mi3nts/PCBMints2025/README.md

# PCBMints2025
Contains PCB designs for MINTS Projects
