mi3nts/PCBMints2025/eagle/methaneSensing/inir2me5/back.png

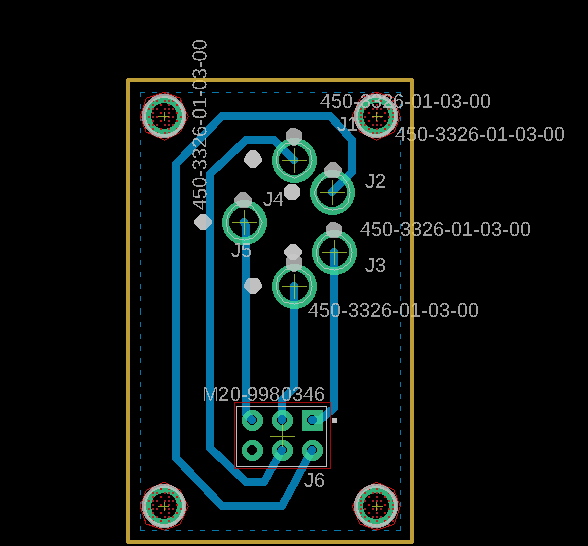
eagle/methaneSensing/inir2me5/back.png
