mi3nts/PCBMints2025/eagle/methaneSensing/sjh5a/back.png

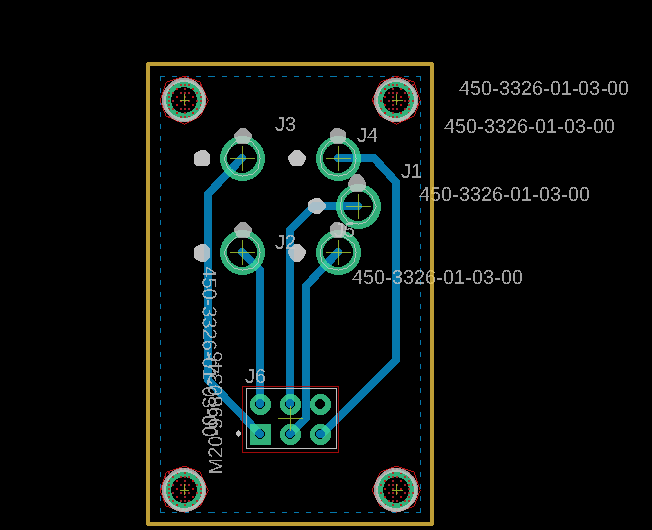
eagle/methaneSensing/sjh5a/back.png
