mi3nts/PCBMints2025/eagle/methaneSensing/tgs2611c00V2/back.png

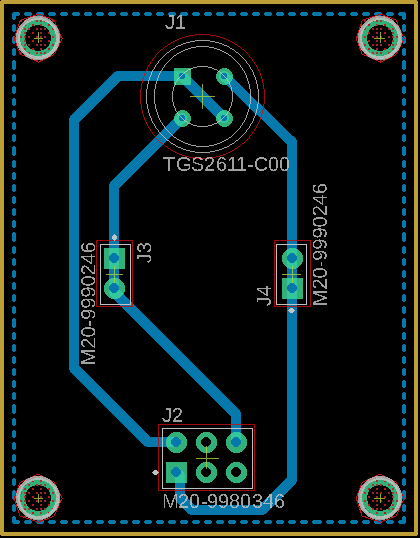
eagle/methaneSensing/tgs2611c00V2/back.png
