mi3nts/PCBMints2025/kiCad/hat/assets/MMUN2133LT1G.step

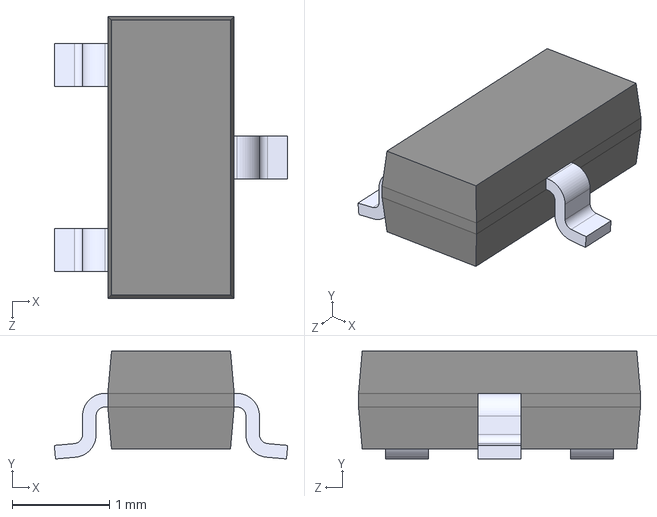
[picture p4: CAD file, 2025-10-30]
kiCad/hat/assets/MMUN2133LT1G.step
2.40 x 1.11 x 2.90 mm
