mi3nts/PCBMints2025/kiCad/hat/assets/RC0603FR-0717K4L.step

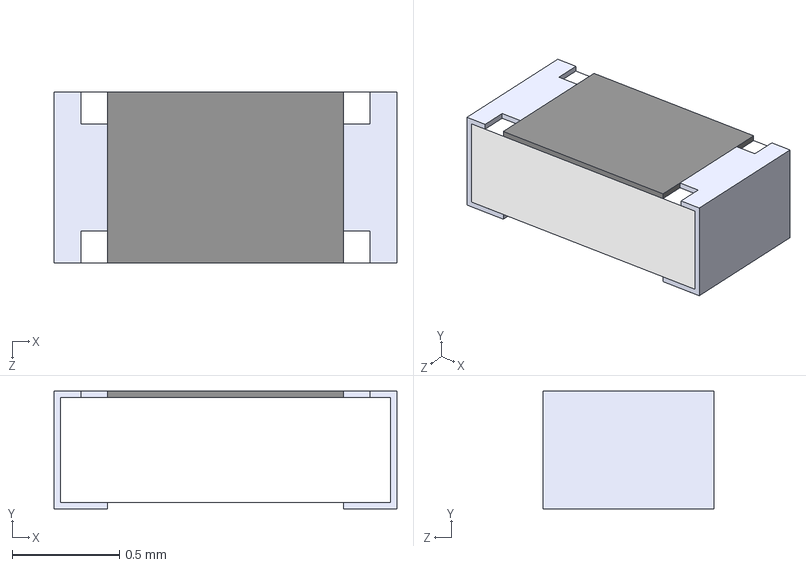
[picture p5: CAD file, 2025-10-30]
kiCad/hat/assets/RC0603FR-0717K4L.step
1.60 x 0.55 x 0.8 mm
