mi3nts/PCBMints2025/res/TGS2611-C00.stp

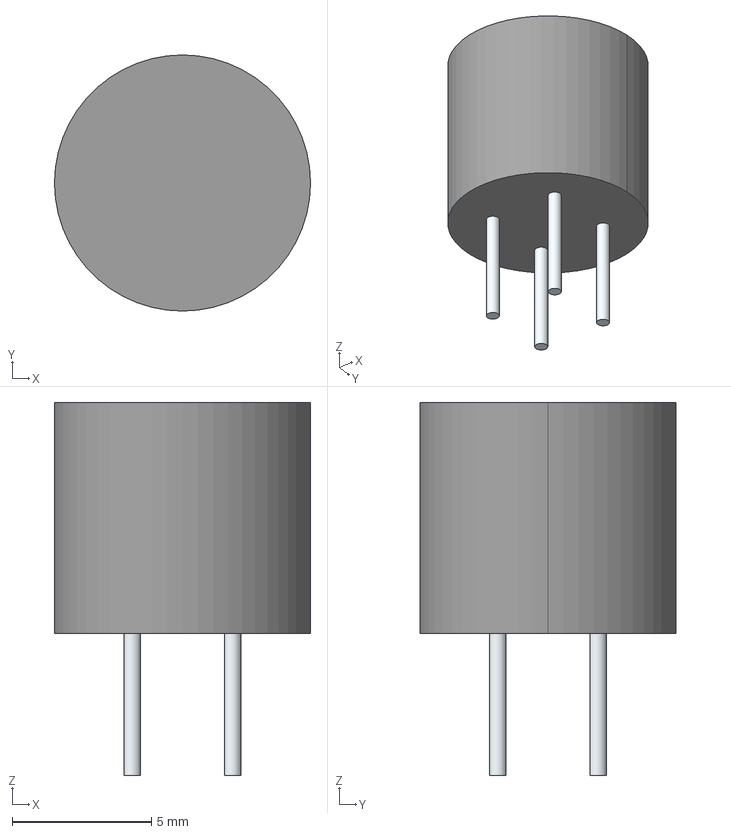
[picture p6: CAD file, 2026-06-27]
res/TGS2611-C00.stp
9.20 x 9.20 x 13.4 mm
Leads x 4
