mi3nts/PCBMints2025/res/5013310607.stp

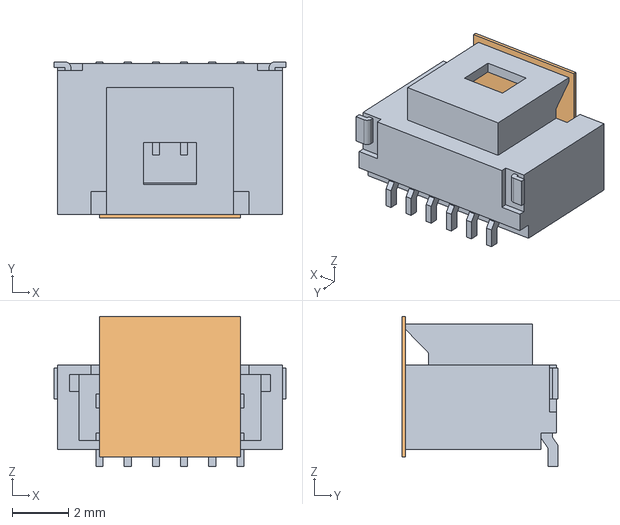
[picture p7: CAD file, 2026-06-27]
res/5013310607.stp
8.24 x 5.54 x 5.34 mm
