mi3nts/PCBMints2025/res/m20-7830542.stp

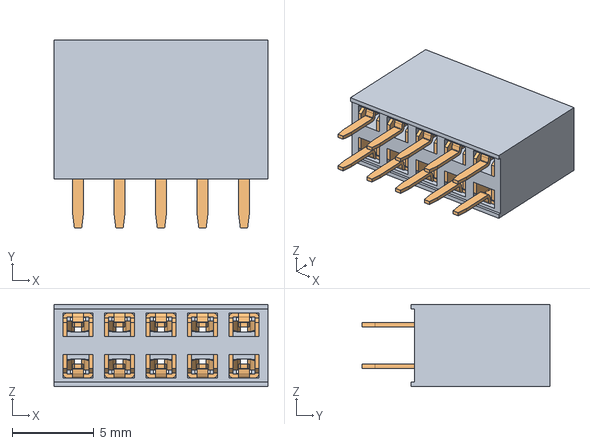
[picture p8: CAD file, 2026-06-27]
res/m20-7830542.stp
13.1 x 11.5 x 5.04 mm
