mi3nts/PCBMints2025/res/679305124022 (rev1).stp

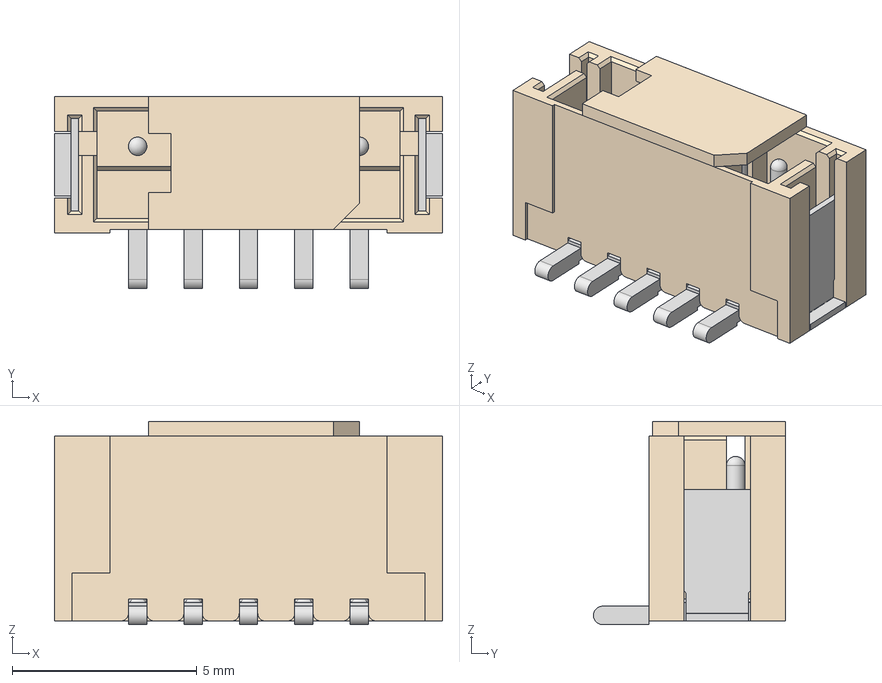
[picture p9: CAD file, 2026-06-27]
res/679305124022 (rev1).stp
10.5 x 5.20 x 5.50 mm
6793xx124022_PIN x 5
6793xx124022_CAP
6793xx124022_PATTE x 2
