mi3nts/PCBMints2025/res/10132328-10011LF.stp

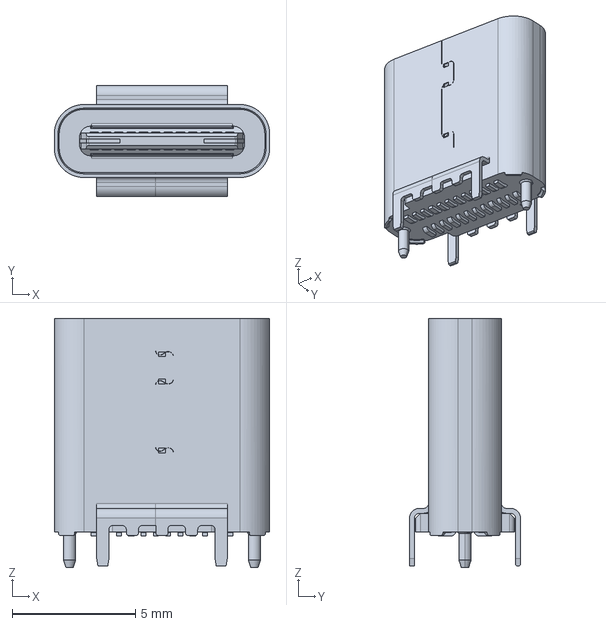
[picture p10: CAD file, 2026-06-27]
res/10132328-10011LF.stp
8.74 x 4.50 x 10.1 mm
