mi3nts/PCBMints2025/(list of files, cad)

Other CAD files:
DaughterBoard/Andon_3pinV1.f3d
