mi3nts/PCBMints2025/kiCad/dream/schematic.pdf

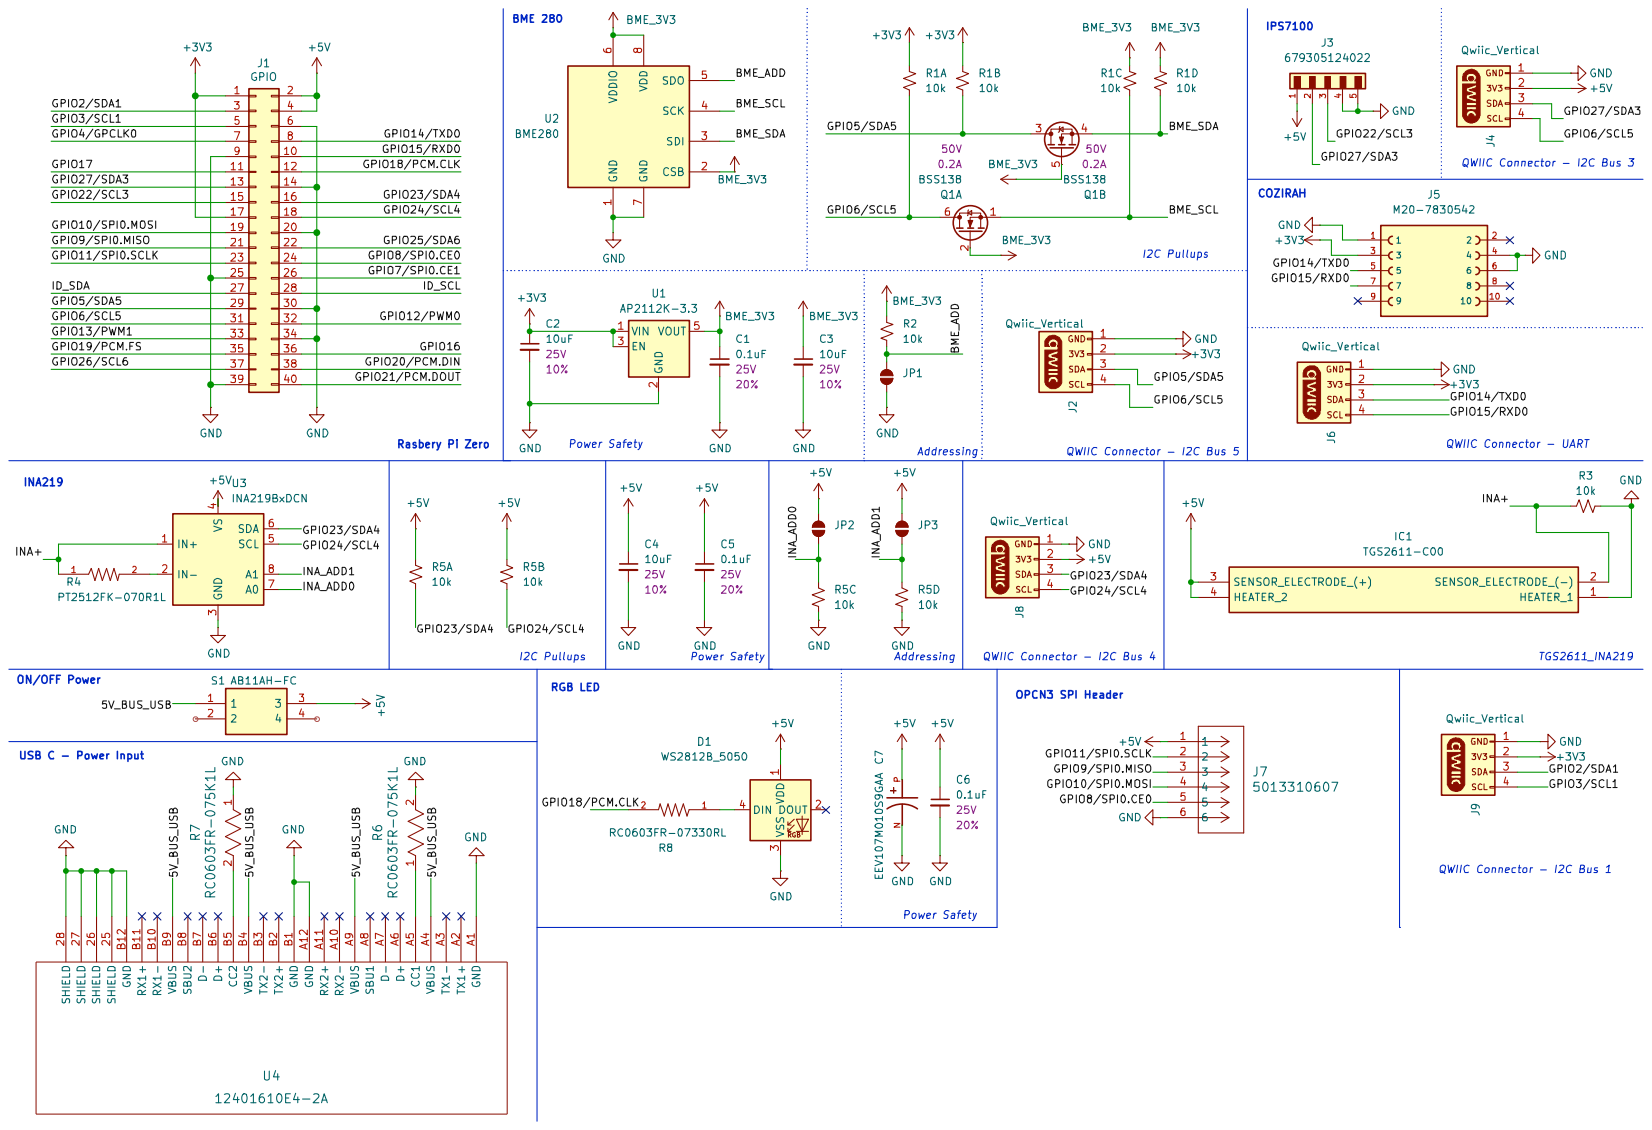
[picture p11: page 1]
