mi3nts/PCBMints2025/(commit log)

2024-11-26 minor updates
    [INIR2-ME5Mount.brd, INIR2-ME5Mount.sch, SJH-5XD.sch, SJH-5XDMount.sch.brd, SJH-5XDMount.sch.sch, Test.sch, tgs2611-c00.brd, tgs2611-c00.sch]
2024-11-27 methane PCBs added
    [INIR2-ME5Mount.brd, INIR2-ME5Mount.sch, SJH-5XDMount.sch.brd, SJH-5XDMount.sch.sch, tgs2611-c00.brd, tgs2611-c00.sch]
2025-09-03 Dream Added
    [dream.kicad_pcb, dream.kicad_sch]
2025-09-04 dream updates
    [PnP_tgs2611-c00_back.csv, PnP_tgs2611-c00_front.csv, dream.kicad_pcb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]
2025-09-04 major updates
    [dream.kicad_pcb]
2025-09-23 PCB updates for dream
    [dreamV1_0.kicad_pcb, dreamV1_0.kicad_sch]
2025-10-23 added hat outline pcb
    [dreamV1_0.kicad_pcb, dreamV1_0.kicad_sch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]
2025-10-30 update hat; PCB reset
    [dreamV1_0.kicad_sch]
2025-10-31 update hat
    [dreamV1_0.kicad_pcb, dreamV1_0.kicad_sch]
2025-11-06 added some to scale drawings for layout design
    [dreamV1_0.kicad_pcb]
2026-01-01 Add files via upload
    Type C moved to be above the GPIO, new switch, subtle mounting hole, and border changes.
    [dreamV1_0.kicad_pcb, dreamV1_0.kicad_sch]
2026-01-02 reverted file structure to contain both v1 and v2
    [dreamV1_0.kicad_pcb, dreamV1_0.kicad_sch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]
2026-01-09 fixed unconnected line
    [dreamV1_0.kicad_pcb]
2026-01-09 Updated gerber
    [BOM-dreamV1_0.csv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]
2026-01-12 Updated ibom
    [dreamV2_0_BOM.csv]
2026-02-24 Add files via upload
    DreamLeo uploaded
    [canopySense_take1.kicad_pcb, canopySense_take1.kicad_sch]
2026-06-02 Add files via upload
    new update after various labeling and cleaning up,
    [Dream_leov1.kicad_pcb, Dream_leov1.kicad_sch]
2026-06-02 update silkscreen
    [Dream_leov1.kicad_pcb]
2026-06-05 Add files via upload
    finishing touches on edge cut and errors
    [Dream_leov1.kicad_pcb]
2026-06-11 Add files via upload
    methane sens flipped and clutter cleaned by gpio3 and 90s cleaned, copper zone added on f.cu and DRC ran and checked. spi logo moved. all the lose traces I could find I cut.
    [Dream_leov1.kicad_pcb]
2026-06-11 partially fixed leo board
    [Dream_leov1.kicad_pcb, dreamV1_0.kicad_pcb]
2026-06-11 restarted traces
    [Dream_leov1.kicad_pcb]
2026-06-11 halfway done v3
    [Dream_leov1.kicad_pcb, Dream_leov1.kicad_sch]
2026-06-12 almost done; need to clean up bottom half maybe
    [Dream_leov1.kicad_pcb]
2026-06-15 fixed issues; update schematic
    [Dream_leov1.kicad_pcb, Dream_leov1.kicad_sch]
2026-06-15 update structure
    [Dream_V3_0.kicad_pcb, Dream_V3_0.kicad_sch, Dream_leov1.kicad_pcb, Dream_leov1.kicad_sch, canopySense_take1.kicad_pcb, canopySense_take1.kicad_sch]
2026-06-18 final john update
    [Dream_leov1.kicad_pcb, Dream_leov1.kicad_sch]
2026-06-27 Final draft DREAM V3
    [10132328-10011LF.stp, 5013310607.stp, 679305124022 (rev1).stp, Dream_V3.kicad_pcb, Dream_V3.kicad_sch, Dream_V3_0.kicad_pcb, Dream_V3_0.kicad_sch, Dream_leov1.kicad_pcb]
2026-06-30 Final DreamV3
    [Dream_V3.kicad_pcb]
2026-06-30 Updated Throughhole
    [Dream_V3.kicad_pcb]
2026-07-01 Updated PCB
    [Dream_V3.kicad_pcb, Dream_V3.kicad_sch]
2026-07-02 ACTUAL final DreamV3
    [Dream_V3.kicad_pcb, Dream_V3.kicad_sch]
2026-07-02 ACTUAL ACTUAL final dreamV3
    [Dream_V3.kicad_pcb]
2026-07-02 FINAL FINAL FINAL PCB
    [Dream_V3.kicad_pcb]
2026-07-02 update switch properties
    [Dream_V3.kicad_pcb]
2026-07-06 split into Orange and Raspberry Pi boards
    [Dream_V3.csv, Dream_V3.kicad_pcb, Dream_V3.kicad_sch]
2026-07-08 split into orangepi and raspi
    [BOM-Dream_V3.csv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]
2026-07-08 update opi pcb
    [Dream_V3.kicad_pcb, Dream_V3.kicad_sch]
2026-07-09 fixed pull ups and changed ina logic level
    [Dream_V3.kicad_pcb, Dream_V3.kicad_sch]
2026-07-14 enable switch to enable mosfet
    [Dream_V3.kicad_pcb, Dream_V3.kicad_sch]
2026-07-16 replaced INA with ADS1115
    [Dream_V3.kicad_pcb, Dream_V3.kicad_sch]
2026-07-16 Full audit
    [simulation_results.csv]
2026-07-16 updated schematic & TGS resistor & switch-fet
    [Dream_V3.kicad_pcb, Dream_V3.kicad_sch]
2026-07-21 update orangepi
    [Dream_V3.kicad_pcb, Dream_V3.kicad_sch]
2026-07-21 critical fix: resistors
    [Dream_V3.kicad_pcb]
2026-07-24 Updated NextPCB Files
    [BOM-Dream_V3.csv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]
