mi3nts/PCBMints2025/(notices)

Notices in the files:
parts and their libraries:
Methane: COPYRIGHT: Copyright (C) 2024 Ultra Librarian. All rights reserved.
SparkFun-PowerSymbols: Licensing: Creative Commons ShareAlike 4.0 International - https://creativecommons.org/licenses/by-sa/4.0
