mi3nts/PCBMints2025/kiCad/dreamV3_rpi/Dream_V3.kicad_pcb

## KiCad design kiCad/dreamV3_rpi/Dream_V3.kicad_pcb (2026-07-06)

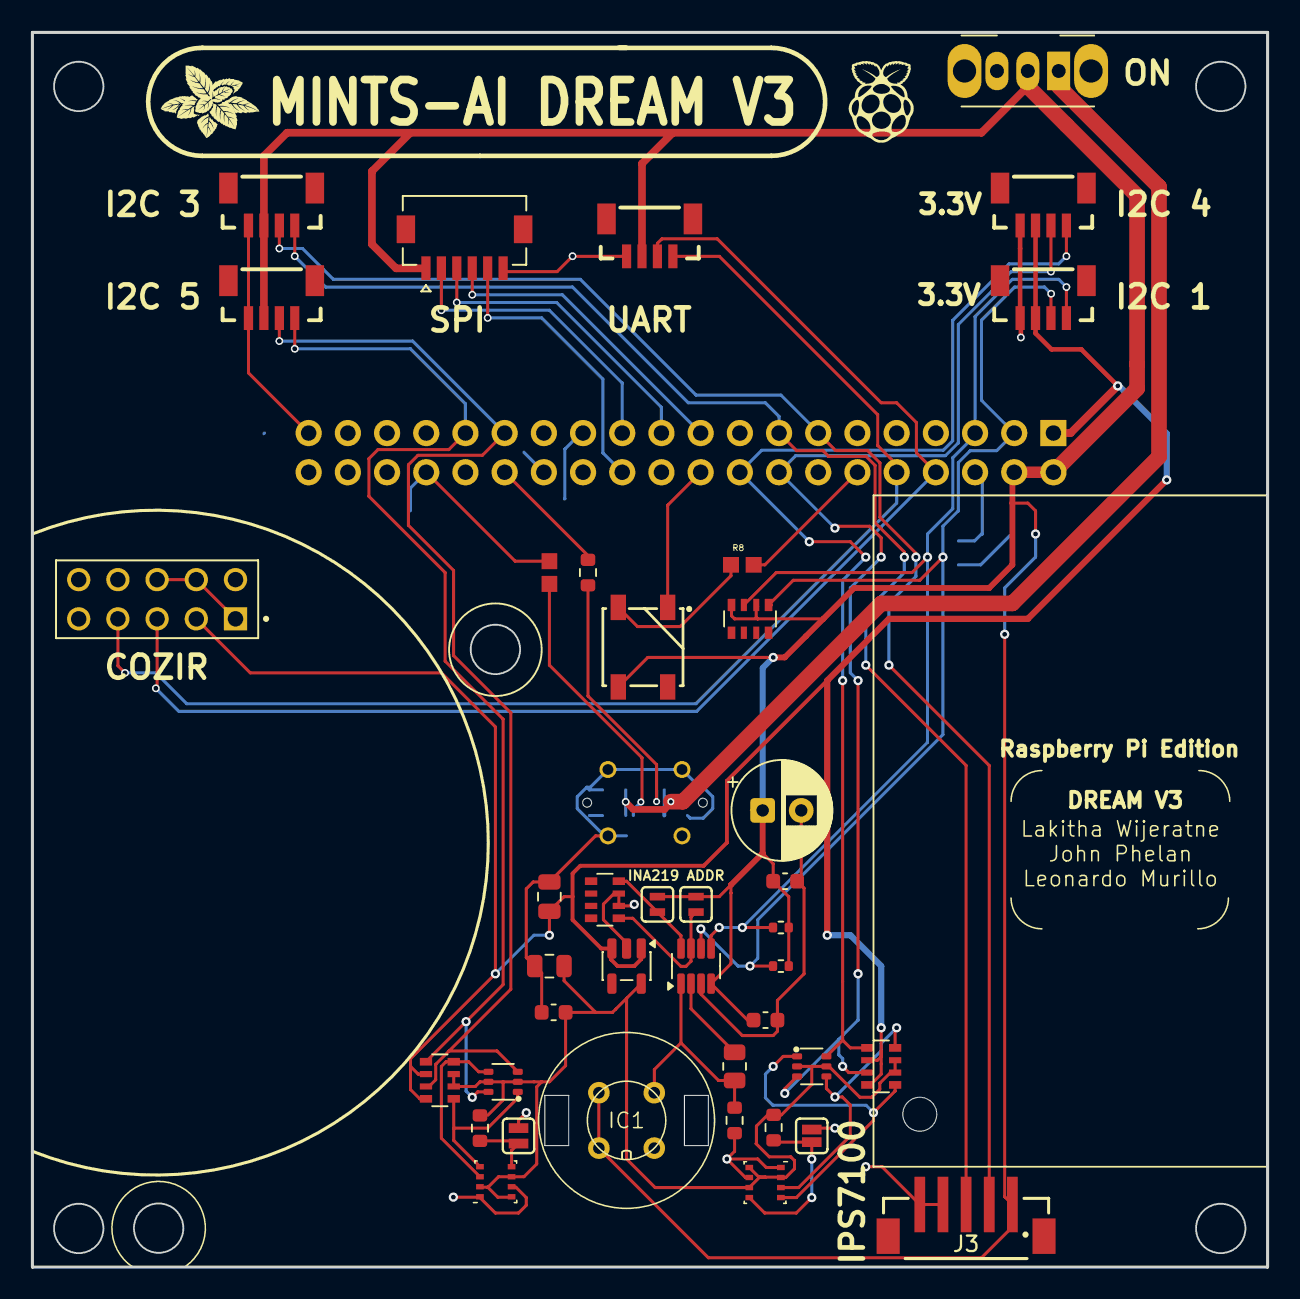
[picture p3: board kiCad/dreamV3_rpi/Dream_V3.kicad_pcb from above]

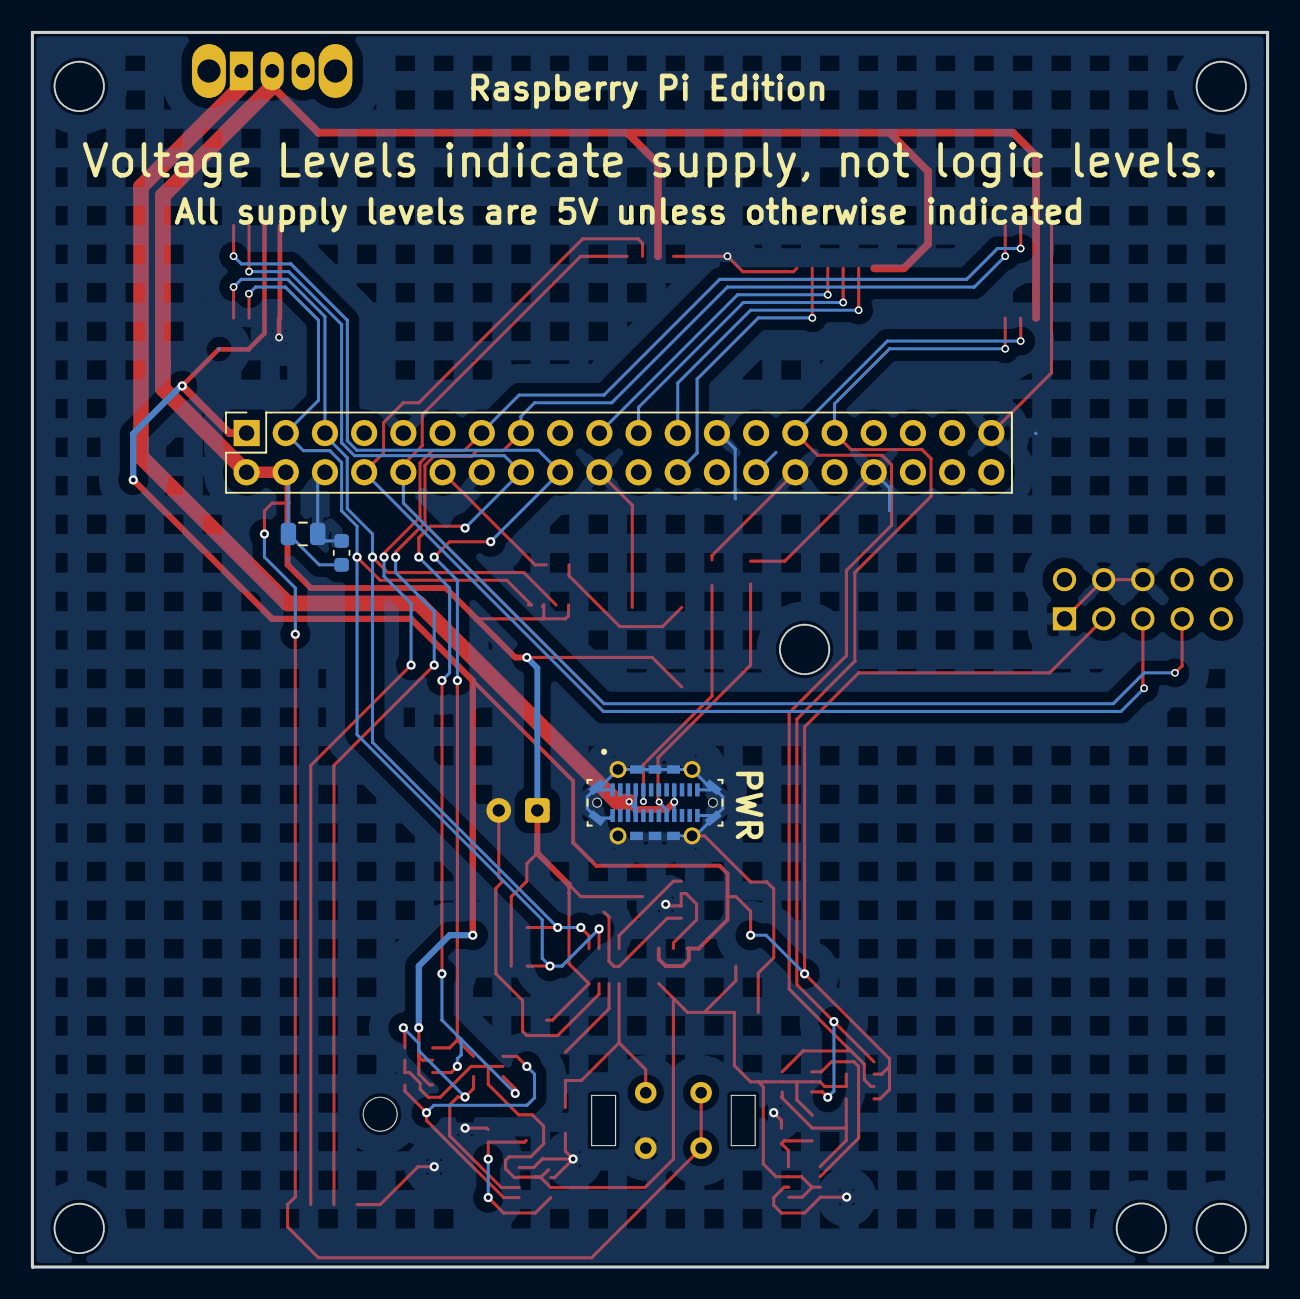
[picture p4: board kiCad/dreamV3_rpi/Dream_V3.kicad_pcb from below]

Board: 2 copper layers, 80.0 x 80.0 mm, 44 parts (4 on the bottom side), 32 nets.

Parts:
C1, C5, C6, C8: 0.1uF; C_0603_1608Metric
C2, C3, C4: 10uF; C_0805_2012Metric
C7: EEV107M010S9GAA; CP_Radial_D6.3mm_P2.50mm
D1: WS2812B_5050; WS2812_5050-4Pin
IC1: TGS2611-C00; tgs2611c00
J1: GPIO; PinSocket_2x20_P2.54mm_Vertical
J2, J4, J6, J9: Qwiic_Vertical; JST_1x04_P1.0mm_Vertical_SMD
J3: 679305124022
J5: M20-7830542
J7: 5013310607; MOLEX_5013310607
J8: Qwiic_4pin_Vertical; JST_1x04_P1.0mm_Vertical_SMD
J11: 10132328-10011LF; AMPHENOL_10132328-10011LF
JP1, JP2, JP3, JP4: Jumper_2_NO
Q1, Q2: BSS138; SOT-363
R1, R2, R5, R13: 10k; R_Array_Convex_4x0603
R3: 2k; R_0603_1608Metric
R4: 0.1; R_0805_2012Metric
R6: RC0603FR-075K1L; RESC1607X60N
R7: 5.1k; R_0603_1608Metric
R8: RC0603FR-07330RL; RESC1607X60N
R9, R10: 10k; R_0603_1608Metric
R11, R12: 3.3k; R_0402_1005Metric
S1: NK236; SW_Slide_SPDT_Angled_CK_OS102011MA1Q
U1: AP2112K-3.3; SOT-23-5
U2, U5: BME280; Bosch_LGA-8_2.5x2.5mm_P0.65mm_ClockwisePinNumbering
U3: INA219BxDCN; SOT-23-8

Connections:
+3V3: C2.1, J1.17, J2.2, J5.3, J8.2, R1.2, R1.4, R13.2, R13.4, U1.1 (VIN)
+5V: C4.1, C5.1, C6.1, C7.P, C8.2, D1.1 (VDD), IC1.3 (SENSOR_ELECTRODE_(+)), IC1.4 (HEATER_2), J1.2, J1.4, J3.1, J4.2, J6.2, J7.1, J9.2, JP2.2 (B), JP3.2 (B), R5.2, R5.4, R11.1, R12.1, S1.2, U3.4 (VS)
/5V_BUS_USB: J11.A4 (VBUS_A4), J11.A9 (VBUS_A9), J11.B4 (VBUS_B4), J11.B9 (VBUS_B9), S1.1
/BME_ADD_1: JP1.2 (B), R9.1, U5.5 (SDO)
/BME_ADD_2: JP4.2 (B), R10.1, U2.5 (SDO)
/BME_SCL1: Q1.1 (S), R1.5, U5.4 (SCK)
/BME_SCL2: Q2.1 (S), R13.5, U2.4 (SCK)
/BME_SDA1: Q1.4 (S), R1.8, U5.3 (SDI)
/BME_SDA2: Q2.4 (S), R13.8, U2.3 (SDI)
/GPIO2/SDA1: J1.3, J2.3, R5.1, R12.2, U3.6 (SDA)
/GPIO3/SCL1: J1.5, J2.4, R5.3, R11.2, U3.5 (SCL)
/GPIO5/SDA5: J1.29, J4.3, Q1.3 (D), R1.3
/GPIO6/SCL5: J1.31, J4.4, Q1.6 (D), R1.1
/GPIO8/SPI0.CE0: J1.24, J7.5
/GPIO9/SPI0.MISO: J1.21, J7.3
/GPIO10/SPI0.MOSI: J1.19, J7.4
/GPIO11/SPI0.SCLK: J1.23, J7.2
/GPIO14/TXD0: J1.8, J5.5, J6.3
/GPIO15/RXD0: J1.10, J5.7, J6.4
/GPIO18/PCM.CLK: J1.12, R8.2
/GPIO22/SCL3: J1.15, J3.3, J9.4
/GPIO23/SDA4: J1.16, J8.3, Q2.3 (D), R13.3
/GPIO24/SCL4: J1.18, J8.4, Q2.6 (D), R13.1
/GPIO27/SDA3: J1.13, J3.2, J9.3
/INA+: IC1.2 (SENSOR_ELECTRODE_(-)), R3.2, R4.1, U3.1 (IN+)
/INA_ADD0: JP2.1 (A), R2.5, U3.7 (A0)
/INA_ADD1: JP3.1 (A), R2.8, U3.8 (A1)
BME_3V3: C1.1, C3.1, Q1.2 (G), Q1.5 (G), Q2.2 (G), Q2.5 (G), R1.6, R1.7, R9.2, R10.2, R13.6, R13.7, U1.5 (VOUT), U2.2 (CSB), U2.6 (VDDIO), U2.8 (VDD), U5.2 (CSB), U5.6 (VDDIO), U5.8 (VDD)
GND: C1.2, C2.2, C3.2, C4.2, C5.2, C6.2, C7.N, C8.1, D1.3 (VSS), IC1.1 (HEATER_1), J1.6, J1.9, J1.14, J1.20, J1.25, J1.30, J1.34, J1.39, J2.1, J3.4, J3.5, J4.1, J5.1, J5.4, J5.6, J6.1, J7.6, J8.1, J9.1, J11.1 (SHIELD), J11.2 (SHIELD__1), J11.3 (SHIELD__2), J11.4 (SHIELD__3), J11.5 (SHIELD__4), J11.6 (SHIELD__5), J11.7 (SHIELD__6), J11.8 (SHIELD__7), J11.9 (SHIELD__8), J11.10 (SHIELD__9), J11.11 (SHIELD__10), J11.12 (SHIELD__11), J11.13 (SHIELD__12), J11.14 (SHIELD__13), J11.A1 (GND_A1), J11.A12 (GND_A12), J11.B1 (GND_B1), J11.B12 (GND_B12), JP1.1 (A), JP4.1 (A), R2.6, R2.7, R3.1, R6.1, R7.1, U1.2 (GND), U2.1 (GND), U2.7 (GND), U3.3 (GND), U5.1 (GND), U5.7 (GND)
unnamed: D1.4 (DIN), R8.1
unnamed: J11.A5 (CC1), R7.2
unnamed: J11.B5 (CC2), R6.2
