mi3nts/PCBMints2025/kiCad/dreamV1_0/dreamV1_0.kicad_pcb

## KiCad design kiCad/dreamV1_0/dreamV1_0.kicad_pcb (2026-06-11, an earlier design)

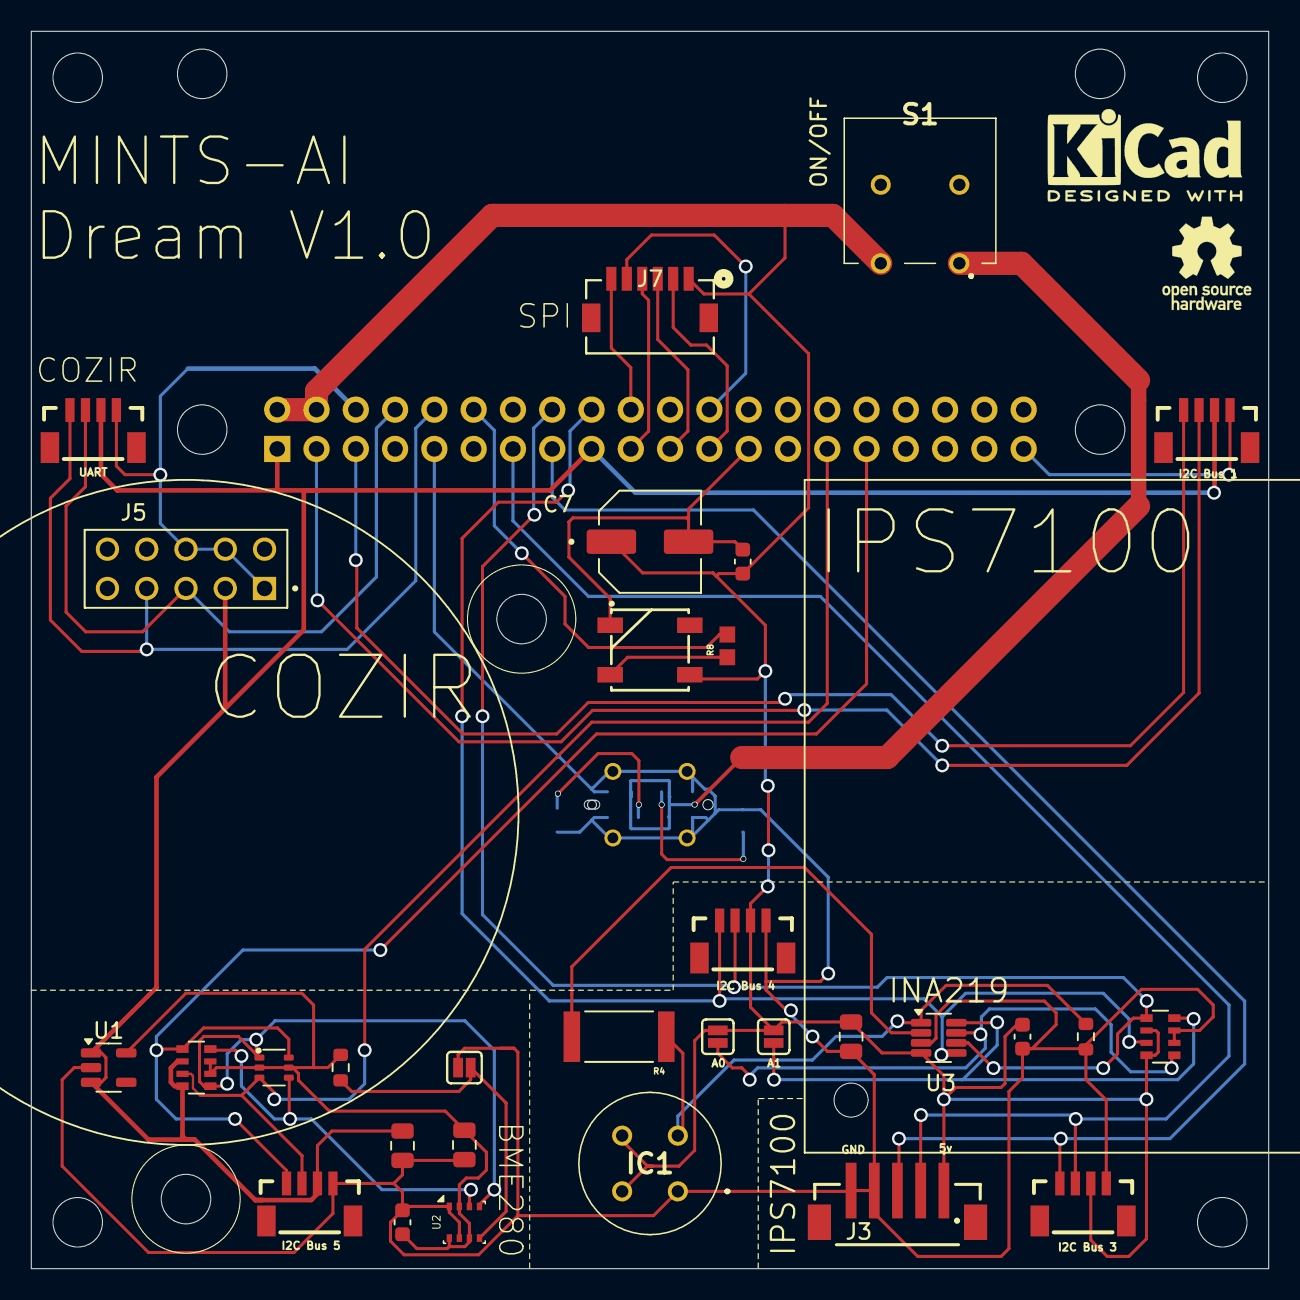
[picture p5: board kiCad/dreamV1_0/dreamV1_0.kicad_pcb from above]

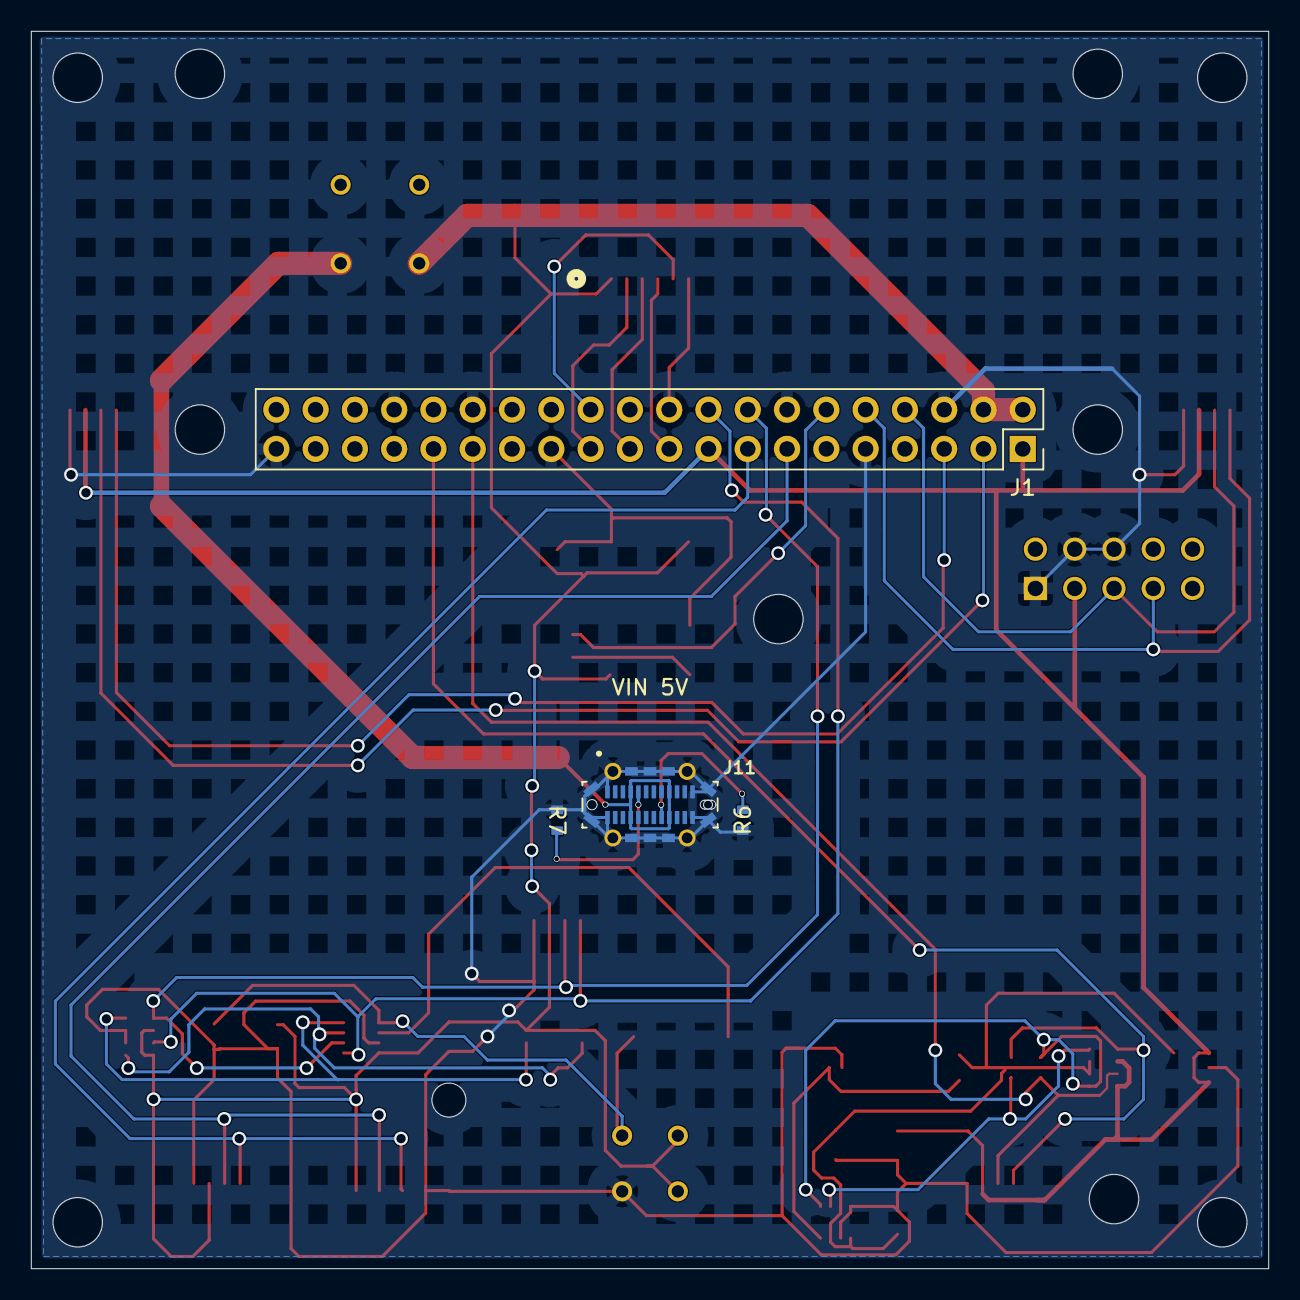
[picture p6: board kiCad/dreamV1_0/dreamV1_0.kicad_pcb from below]

Board: 2 copper layers, 80.0 x 80.0 mm, 35 parts (4 on the bottom side), 30 nets.

Parts:
C1, C5, C6: 0.1uF; C_0603_1608Metric
C2, C3, C4: 10uF; C_0805_2012Metric
C7: EEV107M010S9GAA
D1: WS2812B_5050; WS2812_5050-4Pin
IC1: TGS2611-C00; TGS2611C00
J1: GPIO; PinSocket_2x20_P2.54mm_Vertical
J2, J4, J6, J8, J9: Qwiic_Vertical; JST_SMD_1.0mm-4_Vertical_Black
J3: 679305124022
J5: M20-7830542
J7: 5013310607
J11: 10132328-10011LF
JP1, JP2, JP3: Jumper_2_NO
Q1: BSS138; SOT-363
R1, R5: 10k; R_Array_Convex_4x0603
R2, R3: 10k; R_0603_1608Metric
R4: PT2512FK-070R1L
R6, R7: RC0603FR-075K1L; RC0603N_YAG-L
R8: RC0603FR-07330RL
S1: AB11AH-FC; AB11AHFC
U1: AP2112K-3.3; SOT-23-5
U2: BME280; Bosch_LGA-8_2.5x2.5mm_P0.65mm_ClockwisePinNumbering
U3: INA219BxDCN; SOT-23-8

Connections:
+3V3: C2.1, J1.1, J1.17, J2.2, J5.3, J6.2, J9.2, R1.2, R1.4, U1.1 (VIN), U1.3 (EN)
+5V: C4.1, C5.1, C6.1, C7.P, D1.1 (VDD), IC1.3 (SENSOR_ELECTRODE_(+)), IC1.4 (HEATER_2), J1.2, J1.4, J3.1, J4.2, J7.1, J8.2, JP2.2 (B), JP3.2 (B), R5.2, R5.4, S1.3, U3.4 (VS)
/5V_BUS_USB: J11.A4 (VBUS_A4), J11.A9 (VBUS_A9), J11.B4 (VBUS_B4), J11.B9 (VBUS_B9), S1.1
/BME_ADD: JP1.2 (B), R2.1, U2.5 (SDO)
/BME_SCL: Q1.1 (S), R1.5, U2.4 (SCK)
/BME_SDA: Q1.4 (S), R1.8, U2.3 (SDI)
/GPIO2/SDA1: J1.3, J9.3
/GPIO3/SCL1: J1.5, J9.4
/GPIO5/SDA5: J1.29, J2.3, Q1.3 (D), R1.3
/GPIO6/SCL5: J1.31, J2.4, Q1.6 (D), R1.1
/GPIO8/SPI0.CE0: J1.24, J7.5
/GPIO9/SPI0.MISO: J1.21, J7.3
/GPIO10/SPI0.MOSI: J1.19, J7.4
/GPIO11/SPI0.SCLK: J1.23, J7.2
/GPIO14/TXD0: J1.8, J5.5, J6.3
/GPIO15/RXD0: J1.10, J5.7, J6.4
/GPIO18/PCM.CLK: J1.12, R8.2
/GPIO22/SCL3: J1.15, J3.3, J4.4
/GPIO23/SDA4: J1.16, J8.3, R5.1, U3.6 (SDA)
/GPIO24/SCL4: J1.18, J8.4, R5.3, U3.5 (SCL)
/GPIO27/SDA3: J1.13, J3.2, J4.3
/INA+: IC1.2 (SENSOR_ELECTRODE_(-)), R3.2, R4.1, U3.1 (IN+)
/INA_ADD0: JP2.1 (A), R5.5, U3.7 (A0)
/INA_ADD1: JP3.1 (A), R5.8, U3.8 (A1)
BME_3V3: C1.1, C3.1, Q1.2 (G), Q1.5 (G), R1.6, R1.7, R2.2, U1.5 (VOUT), U2.2 (CSB), U2.6 (VDDIO), U2.8 (VDD)
GND: C1.2, C2.2, C3.2, C4.2, C5.2, C6.2, C7.N, D1.3 (VSS), IC1.1 (HEATER_1), J1.6, J1.9, J1.14, J1.20, J1.25, J1.30, J1.34, J1.39, J2.1, J3.4, J3.5, J4.1, J5.1, J5.4, J5.6, J6.1, J7.6, J8.1, J9.1, J11.1 (SHIELD), J11.2 (SHIELD__1), J11.3 (SHIELD__2), J11.4 (SHIELD__3), J11.5 (SHIELD__4), J11.6 (SHIELD__5), J11.7 (SHIELD__6), J11.8 (SHIELD__7), J11.9 (SHIELD__8), J11.10 (SHIELD__9), J11.11 (SHIELD__10), J11.12 (SHIELD__11), J11.13 (SHIELD__12), J11.14 (SHIELD__13), J11.A1 (GND_A1), J11.A12 (GND_A12), J11.B1 (GND_B1), J11.B12 (GND_B12), JP1.1 (A), R3.1, R5.6, R5.7, R6.1, R7.1, U1.2 (GND), U2.1 (GND), U2.7 (GND), U3.3 (GND)
unnamed: D1.4 (DIN), R8.1
unnamed: J11.A5 (CC1), R7.2
unnamed: J11.B5 (CC2), R6.2
unnamed: R4.2, U3.2 (IN-)
