mi3nts/PCBMints2025/kiCad/hat/dreamV1_0.kicad_pcb

## KiCad design kiCad/hat/dreamV1_0.kicad_pcb (2025-11-06, an earlier design)

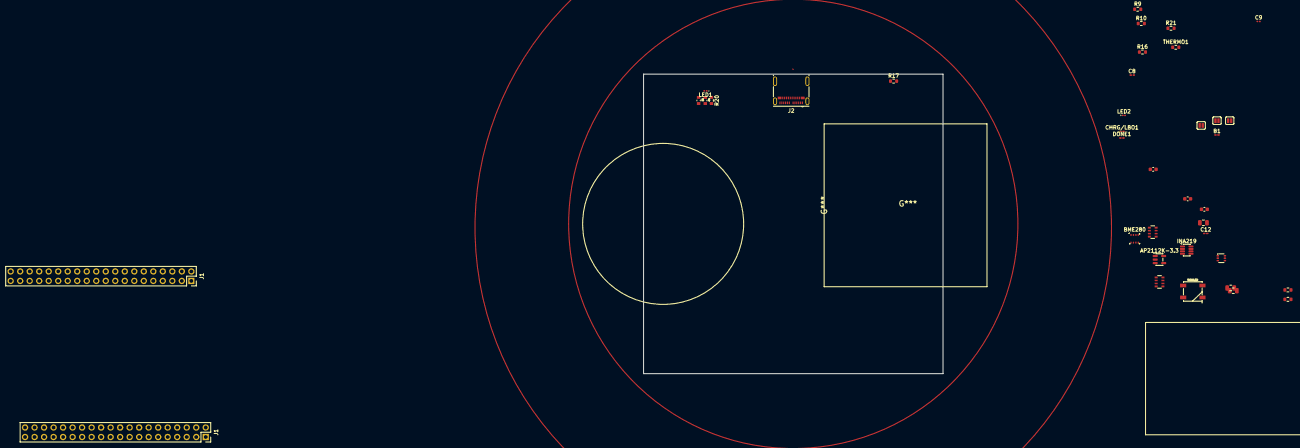
[picture p7: board kiCad/hat/dreamV1_0.kicad_pcb from above]

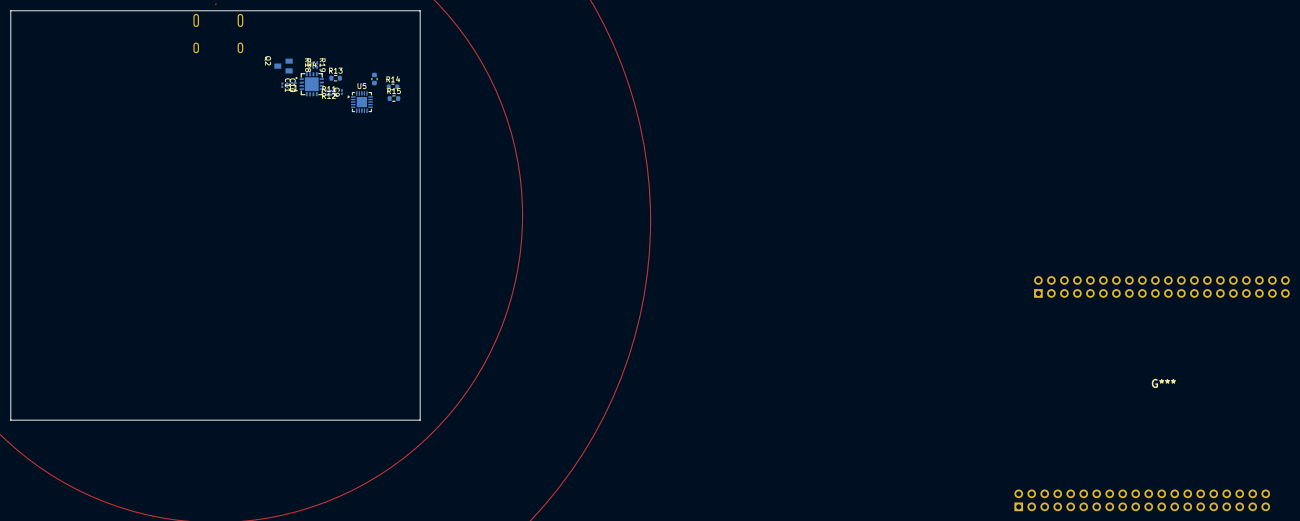
[picture p8: board kiCad/hat/dreamV1_0.kicad_pcb from below]

Board: 4 copper layers, 80.0 x 80.0 mm, 54 parts (16 on the bottom side), 50 nets.

Parts:
AP2112K-3.3: AP2112K-3.3; SOT-23-5
B1: JST 2-PH; C_0201_0603Metric_Pad0.64x0.40mm_HandSolder
BME280: BME280; Bosch_LGA-8_2.5x2.5mm_P0.65mm_ClockwisePinNumbering
C1, C2, C5: 10uF; C_0805_2012Metric
C3, C4, C7: 0.1uF; C_0603_1608Metric
C8, C8#2, C12: 10uF; C_0201_0603Metric_Pad0.64x0.40mm_HandSolder
C9, C9#2: 0.1uF; C_0201_0603Metric
C10: 2.2uF; C_0201_0603Metric
C11: 100uF; C_0201_0603Metric
C13: 10uF; C_0603_1608Metric
CHRG/LBO1: ORANGE; C_0201_0603Metric_Pad0.64x0.40mm_HandSolder
DONE1: GREEN; C_0201_0603Metric_Pad0.64x0.40mm_HandSolder
INA219: INA219BxDCN; SOT-23-8
J1, J1#2: GPIO; PinSocket_2x20_P2.54mm_Vertical
J2: 10132328-10011LF; USB_C_Receptacle_Molex_105450-0101
JP1, JP2, JP3: Jumper_2_NO
L1: 6.8uH; L_0201_0603Metric
LED1: RED; LED_0201_0603Metric
LED2: BLUE; LED_0201_0603Metric
Q1: BSS138; SOT-363
Q2: MMUN2133LT1G; SOT95P240X111-3N
R1, R4: RC0603FR-075K1L; RESC1608X55N
R3, R7: 10k; R_Array_Convex_4x0603
R6, R8: 10k; R_0603_1608Metric
R9, R10, R16, R20, R21: 1k; R_0603_1608Metric
R11, R18: 1.87m; R_0201_0603Metric_Pad0.64x0.40mm_HandSolder
R12: 340k; R_0201_0603Metric_Pad0.64x0.40mm_HandSolder
R13: 200k; R_0603_1608Metric
R14: 270k; R_0603_1608Metric
R15, R17: 100k; R_0603_1608Metric
R19: 200k; R_0201_0603Metric_Pad0.64x0.40mm_HandSolder
RGBLED: WS2812B_5050; WS2812_5050-4Pin
THERMO1: 15k; R_0603_1608Metric
U4: TPS61090RSAR; QFN65P400X400X100-17N
U5: MCP73871; QFN-20-1EP_3.5x3.5mm_P0.5mm_EP2x2mm

Connections:
5.0V: C10.1, C11.1, R18.2, R21.2, U4.1 (VOUT), U4.15 (VOUT), U4.16 (VOUT)
5V_BUS_USB: C13.2, J2.A4 (VBUS_A4), J2.A9 (VBUS_A9), J2.B4 (VBUS_B4), J2.B9 (VBUS_B9), R14.2
+3V3: AP2112K-3.3.1 (VIN), AP2112K-3.3.3 (EN), C1.1, J1.1, J1.17, J1#2.1, J1#2.17, R7.2, R7.4
+5V: C2.1, C3.1, C7.1, INA219.4 (VS), J1.2, J1.4, J1#2.2, J1#2.4, JP1.2 (B), JP3.2 (B), R3.2, R3.4, RGBLED.1 (VDD)
/BME_ADD: BME280.5 (SDO), JP2.2 (B), R6.1
/BME_SCL: BME280.4 (SCK), Q1.1 (S), R7.5
/BME_SDA: BME280.3 (SDI), Q1.4 (S), R7.8
/GPIO2/SDA1: J1.3, J1#2.3
/GPIO3/SCL1: J1.5, J1#2.5
/GPIO4/GPCLK0: J1.7, J1#2.7
/GPIO5/SDA5: J1.29, J1#2.29, Q1.3 (D), R7.3
/GPIO6/SCL5: J1.31, J1#2.31, Q1.6 (D), R7.1
/GPIO7/SPI0.CE1: J1.26, J1#2.26
/GPIO8/SPI0.CE0: J1.24, J1#2.24
/GPIO9/SPI0.MISO: J1.21, J1#2.21
/GPIO10/SPI0.MOSI: J1.19, J1#2.19
/GPIO11/SPI0.SCLK: J1.23, J1#2.23
/GPIO12/PWM0: J1.32, J1#2.32
/GPIO13/PWM1: J1.33, J1#2.33
/GPIO14/TXD0: J1.8, J1#2.8
/GPIO15/RXD0: J1.10, J1#2.10
/GPIO16: J1.36, J1#2.36
/GPIO17: J1.11, J1#2.11
/GPIO18/PCM.CLK: J1.12, J1#2.12
/GPIO19/PCM.FS: J1.35, J1#2.35
/GPIO20/PCM.DIN: J1.38, J1#2.38
/GPIO21/PCM.DOUT: J1.40, J1#2.40
/GPIO22/SCL3: J1.15, J1#2.15
/GPIO23/SDA4: INA219.6 (SDA), J1.16, J1#2.16, R3.1
/GPIO24/SCL4: INA219.5 (SCL), J1.18, J1#2.18, R3.3
/GPIO25/SDA6: J1.22, J1#2.22
/GPIO26/SCL6: J1.37, J1#2.37
/GPIO27/SDA3: J1.13, J1#2.13
/ID_SCL: J1.28, J1#2.28
/ID_SDA: J1.27, J1#2.27
/INA+: INA219.1 (IN+), R8.2
/INA_ADD0: INA219.7 (A0), JP1.1 (A), R3.5
/INA_ADD1: INA219.8 (A1), JP3.1 (A), R3.8
/LBO: Q2.1 (B), U4.12 (LBO)
BME_3V3: AP2112K-3.3.5 (VOUT), BME280.2 (CSB), BME280.6 (VDDIO), BME280.8 (VDD), C4.1, C5.1, Q1.2 (G), Q1.5 (G), R6.2, R7.6, R7.7
GND: AP2112K-3.3.2 (GND), B1.1 (-), BME280.1 (GND), BME280.7 (GND), C1.2, C2.2, C3.2, C4.2, C5.2, C7.2, C8.2, C8#2.2, C9.2, C9#2.2, C10.2, C11.2, C12.2, C13.1, INA219.3 (GND), J1.6, J1.9, J1.14, J1.20, J1.25, J1.30, J1.34, J1.39, J1#2.6, J1#2.9, J1#2.14, J1#2.20, J1#2.25, J1#2.30, J1#2.34, J1#2.39, J2.A1 (GND_A1), J2.A12 (GND_A12), J2.B1 (GND_B1), J2.B12 (GND_B12), JP2.1 (A), R1.1, R3.6, R3.7, R4.1, R8.1, R12.1, R15.1, R16.1, R17.1, R19.1, RGBLED.3 (VSS), THERMO1.1, U4.5 (PGND), U4.6 (PGND), U4.7 (PGND), U4.10 (SYNC), U4.13 (GND)
unnamed: J2.A5 (CC1), R1.2
unnamed: J2.B5 (CC2), R4.2
unnamed: U4.3 (SW), U4.4 (SW)
unnamed: Q2.3 (C), R20.2
unnamed: R13.1, U4.11 (EN)
unnamed: R18.1, R19.2, U4.14 (FB)
unnamed: R14.1, R15.2
VBAT: C8.1, C8#2.1, C9.1, C9#2.1, Q2.2 (E), R11.2, R13.2, U4.8 (VBAT)
VLIPO: B1.2 (+), C12.1
